dangrie158/AtmoNode/BOM.xlsx

Id | Designator | Footprint | Quantity | Comment | Supplier and ref
1 | R12 | 603 | 1 | 560k
2 | C4,C14 | 805 | 2 | 10u
3 | L1 | 0402.77x0.64mm_HandSolder | 1 | DNP
5 | U5 | Bosch_LGA-8_2.5x2.5mm_P0.65mm_ClockwisePinNumbering | 1 | BME280
6 | R11,R10,R9,R13,R8,R7,R5 | 402 | 7 | 4.7k
7 | C24,C15,C16,C12,C10,C9,C5,C3,C2,C1 | 402 | 10 | 100n 16V
9 | C20,C21 | 603 | 2 | 1u 16V
10 | L2 | 402 | 1 | 3.9nH
19 | Q2,Q1 | SOT-23 | 2 | S9012
20 | R14,R15 | 402 | 2 | 47k
21 | J2 | WiseChip VG-6432TSWAG01 | 1 | OLED_I2C
22 | R3,R6,R4 | 402 | 3 | 12k
23 | U2 | SOIC | 1 | CH340C
25 | C19 | 603 | 1 | 4.7u/16V
26 | C17 | 603 | 1 | 2.2u/16V
28 | R2,R1 | 402 | 2 | 470
29 | C22 | 402 | 1 | 100n 16V
30 | C18 | 402 | 1 | 100n 16V
31 | C13,C11 | 402 | 2 | 10p
32 | C8,C6 | 402 | 2 | DNP
33 | C7 | 402 | 1 | 6pf
35 | Y1 | 3225 | 1 | 26MHz
36 | Q4 | SOT-23 | 1 | FDN335N
37 | Q3 | SOT-23 | 1 | FDN338P
40 | U4 | SOIC-8 | 1 | W25Q16JVSSIQ
41 | U3 | QFN-32 | 1 | ESP8266EX
42 | U1 | SOT-223 | 1 | AP1117-33
45 | D1 | D_SOD-123 | 1 | B5819W
46 | C23 | 603 | 1 | 4.7u/6.3V
