dangrie158/AtmoNode/Board/AtmoNode.kicad_pcb

## KiCad design Board/AtmoNode.kicad_pcb (2023-02-21)

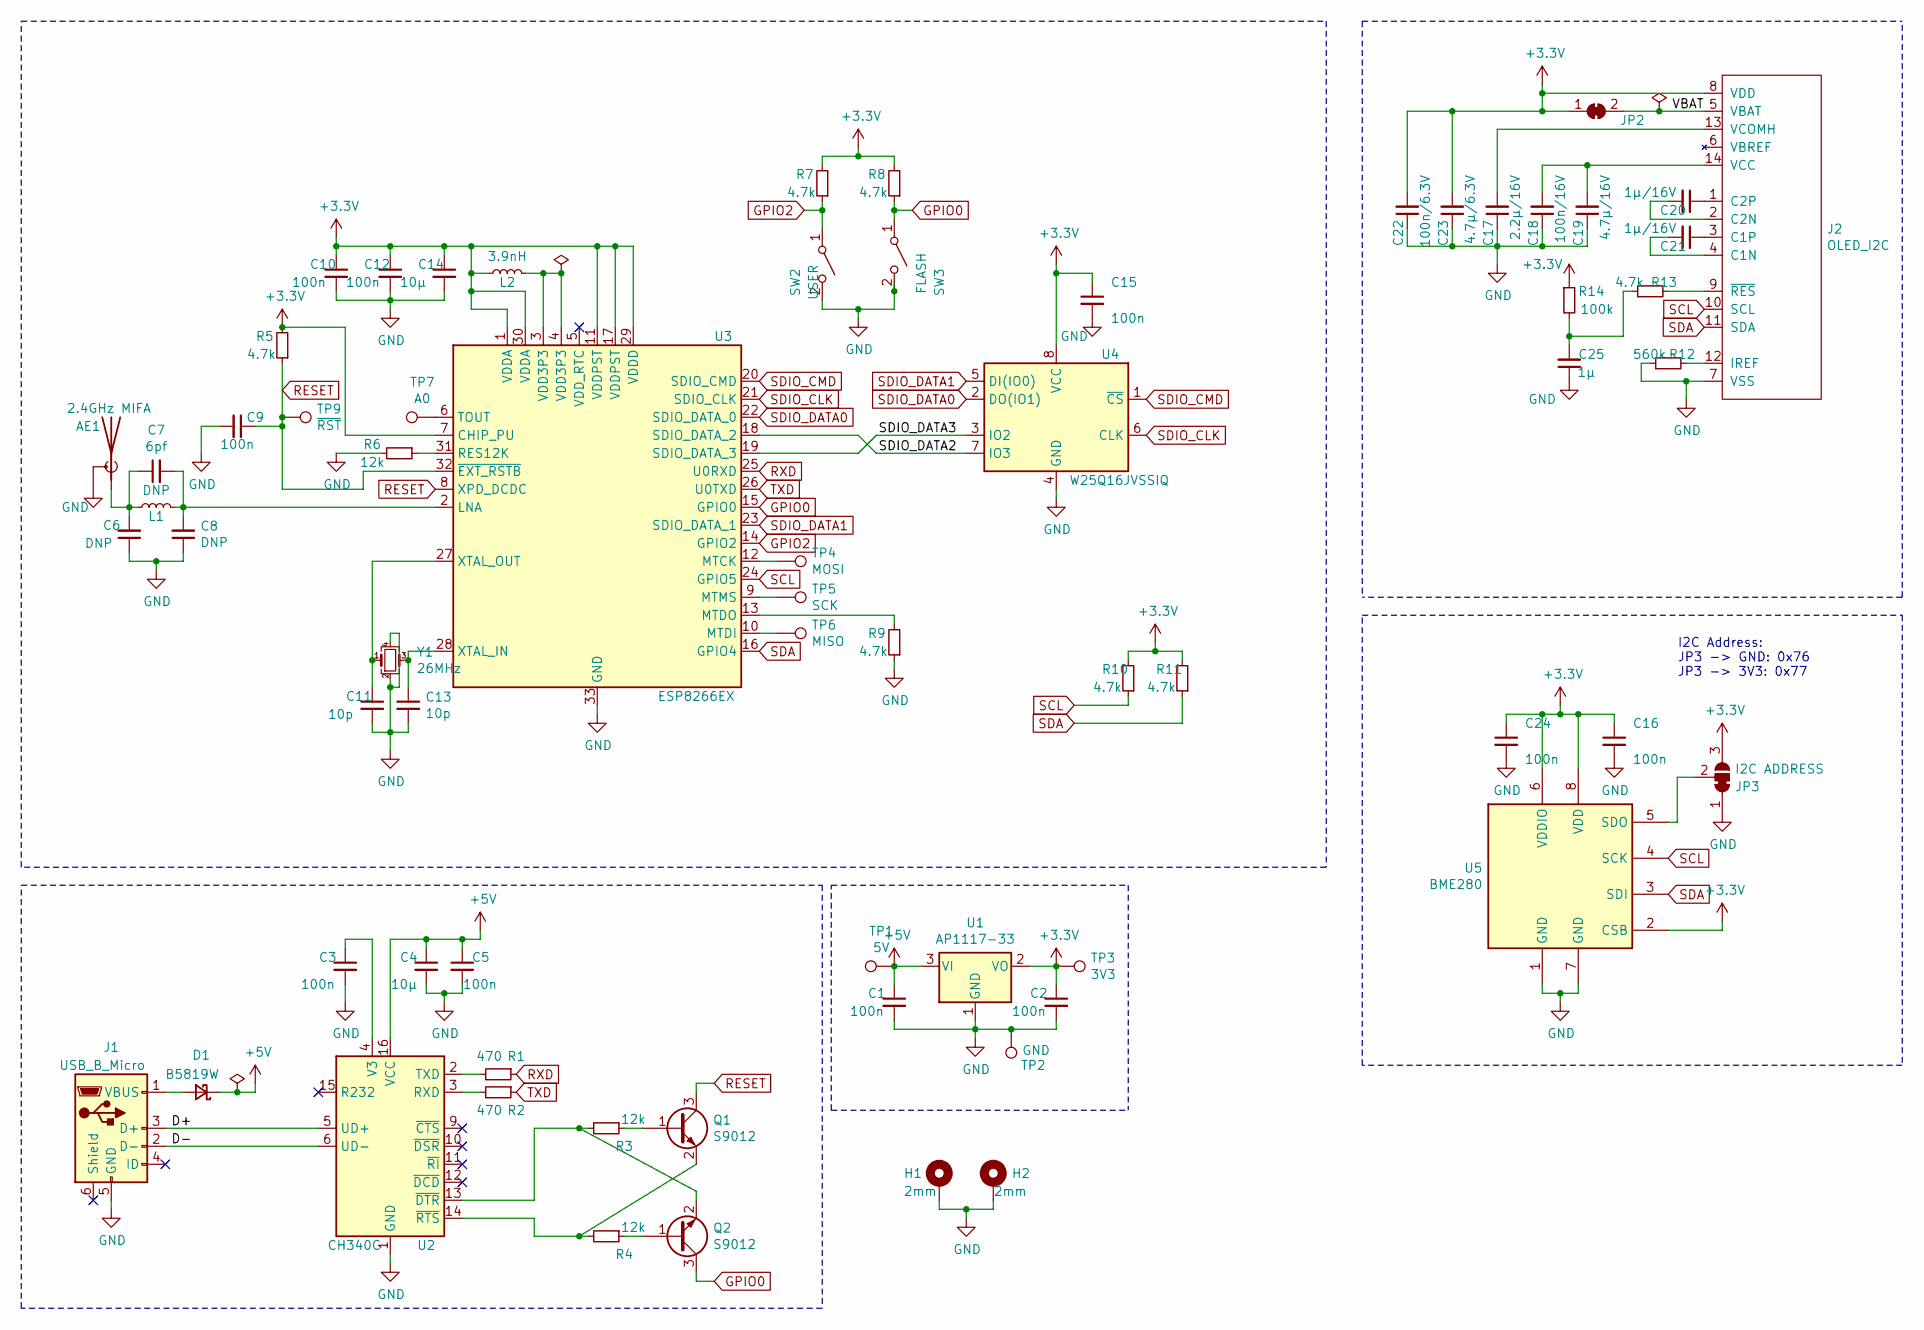
[picture p1: schematic AtmoNode.sch]

Parts:
AE1: 2.4GHz MIFA; Texas_SWRA117D_2.4GHz_Right
C1, C2, C3, C5, C9, C10, C12, C15, C16, C24: 100n; C_0402_1005Metric
C4, C14: 10µ; C_0805_2012Metric
C6, C8: DNP; C_0402_1005Metric
C7: 6pf; C_0402_1005Metric
C11, C13: 10p; C_0402_1005Metric
C17: 2.2µ/16V; C_0603_1608Metric
C18: 100n/16V; C_0402_1005Metric
C19: 4.7µ/16V; C_0603_1608Metric
C20, C21: 1µ/16V; C_0603_1608Metric
C22: 100n/6.3V; C_0402_1005Metric
C23: 4.7µ/6.3V; C_0603_1608Metric
C25: 1µ; C_0603_1608Metric
D1: B5819W; D_SOD-123
H1, H2: 2mm; MountingHole_2.2mm_M2_Pad_Via
J1: USB_B_Micro; USB_Micro-B_Amphenol_10118194_Horizontal
J2: OLED_I2C; WiseChip VG-6432TSWAG01
JP2: VDD-VBAT; SolderJumper-2_P1.3mm_Bridged_RoundedPad1.0x1.5mm
JP3: I2C ADDRESS; SolderJumper-3_P1.3mm_Bridged2Bar12_RoundedPad1.0x1.5mm
L1: DNP; L_0402_1005Metric_Pad0.77x0.64mm_HandSolder
L2: 3.9nH; L_0402_1005Metric_Pad0.77x0.64mm_HandSolder
Q1, Q2: S9012; SOT-23
R1, R2: 470; R_0402_1005Metric
R3, R4, R6: 12k; R_0402_1005Metric
R5, R7, R8, R9, R10, R11, R13: 4.7k; R_0402_1005Metric
R12: 560k; R_0603_1608Metric
R14: 100k; R_0402_1005Metric
SW2: USER; SW_SPST_CK_RS282G05A3
SW3: FLASH; SW_SPST_CK_RS282G05A3
TP1: 5V; TP1.0
TP2: GND; TP1.0
TP3: 3V3; TP1.0
TP4: MOSI; TP1.0
TP5: SCK; TP1.0
TP6: MISO; TP1.0
TP7: A0; TP1.0
TP9: ~RST; TP1.0
U1: AP1117-33; SOT-223-3_TabPin2
U2: CH340C; SOIC-16_3.9x9.9mm_P1.27mm
U3: ESP8266EX; QFN-32-1EP_5x5mm_P0.5mm_EP3.45x3.45mm
U4: W25Q16JVSSIQ; SOIC-8_5.23x5.23mm_P1.27mm
U5: BME280; Bosch_LGA-8_2.5x2.5mm_P0.65mm_ClockwisePinNumbering
Y1: 26MHz; Crystal_SMD_3225-4Pin_3.2x2.5mm

Connections:
+3V3: C2.1, C10.1, C12.1, C14.1, C15.1, C16.1, C22.2, C23.2, C24.1, J2.8 (VDD), JP2.1 (A), JP3.3 (B), L2.1, R5.2, R7.2, R8.2, R10.2, R11.2, R14.1, TP3.1, U1.2 (VO), U3.1 (VDDA), U3.7 (CHIP_PU), U3.11 (VDDPST), U3.17 (VDDPST), U3.29 (VDDD), U3.30 (VDDA), U4.8 (VCC), U5.2 (CSB), U5.6 (VDDIO), U5.8 (VDD)
+5V: C1.1, C4.1, C5.1, D1.1 (K), TP1.1, U1.3 (VI), U2.16 (VCC)
/D+: J1.3 (D+), U2.5 (UD+)
/D-: J1.2 (D-), U2.6 (UD-)
/SDIO_DATA2: U3.18 (SDIO_DATA_2), U4.7 (IO3)
/SDIO_DATA3: U3.19 (SDIO_DATA_3), U4.3 (IO2)
/VBAT: J2.5 (VBAT), JP2.2 (B)
GND: AE1.2 (Shield), C1.2, C2.2, C3.2, C4.2, C5.2, C6.1, C8.1, C9.2, C10.2, C11.2, C12.2, C13.2, C14.2, C15.2, C16.2, C17.1, C18.1, C19.1, C22.1, C23.1, C24.2, C25.1, H1.1, H2.1, J1.5 (GND), J2.7 (VSS), JP3.1 (A), R6.2, R9.1, R12.1, SW2.2 (B), SW3.2 (B), TP2.1, U1.1 (GND), U2.1 (GND), U3.33 (GND), U4.4 (GND), U5.1 (GND), U5.7 (GND), Y1.2, Y1.4
GPIO0: Q2.3 (C), R8.1, SW3.1 (A), U3.15 (GPIO0)
GPIO2: R7.1, SW2.1 (A), U3.14 (GPIO2)
unnamed: AE1.1 (A), C6.2, C7.1, L1.1
unnamed: C3.1, U2.4 (V3)
unnamed: C7.2, C8.2, L1.2, U3.2 (LNA)
unnamed: C11.1, U3.27 (XTAL_OUT), Y1.1
unnamed: C13.1, U3.28 (XTAL_IN), Y1.3
unnamed: C17.2, J2.13 (VCOMH)
unnamed: C18.2, C19.2, J2.14 (VCC)
unnamed: C20.1, J2.1 (C2P)
unnamed: C20.2, J2.2 (C2N)
unnamed: C21.1, J2.3 (C1P)
unnamed: C21.2, J2.4 (C1N)
unnamed: C25.2, R13.1, R14.2
unnamed: D1.2 (A), J1.1 (VBUS)
unnamed: J2.9 (~RES), R13.2
unnamed: J2.12 (IREF), R12.2
unnamed: JP3.2 (C), U5.5 (SDO)
unnamed: L2.2, U3.3 (VDD3P3), U3.4 (VDD3P3)
unnamed: Q1.1 (B), R3.1
unnamed: Q1.2 (E), R4.2, U2.14 (~RTS)
unnamed: Q2.1 (B), R4.1
unnamed: Q2.2 (E), R3.2, U2.13 (~DTR)
unnamed: R1.2, U2.2 (TXD)
unnamed: R2.2, U2.3 (RXD)
unnamed: R6.1, U3.31 (RES12K)
unnamed: R9.2, U3.13 (MTDO)
unnamed: TP4.1, U3.12 (MTCK)
unnamed: TP5.1, U3.9 (MTMS)
unnamed: TP6.1, U3.10 (MTDI)
unnamed: TP7.1, U3.6 (TOUT)
RESET: C9.1, Q1.3 (C), R5.1, TP9.1, U3.8 (XPD_DCDC), U3.32 (~EXT_RSTB)
RXD: R1.1, U3.25 (U0RXD)
SCL: J2.10 (SCL), R10.1, U3.24 (GPIO5), U5.4 (SCK)
SDA: J2.11 (SDA), R11.1, U3.16 (GPIO4), U5.3 (SDI)
SDIO_CLK: U3.21 (SDIO_CLK), U4.6 (CLK)
SDIO_CMD: U3.20 (SDIO_CMD), U4.1 (~CS)
SDIO_DATA0: U3.22 (SDIO_DATA_0), U4.2 (DO(IO1))
SDIO_DATA1: U3.23 (SDIO_DATA_1), U4.5 (DI(IO0))
TXD: R2.1, U3.26 (U0TXD)

Notes on the sheet:
I2C Address: JP3 -> GND: 0x76 JP3 -> 3V3: 0x77

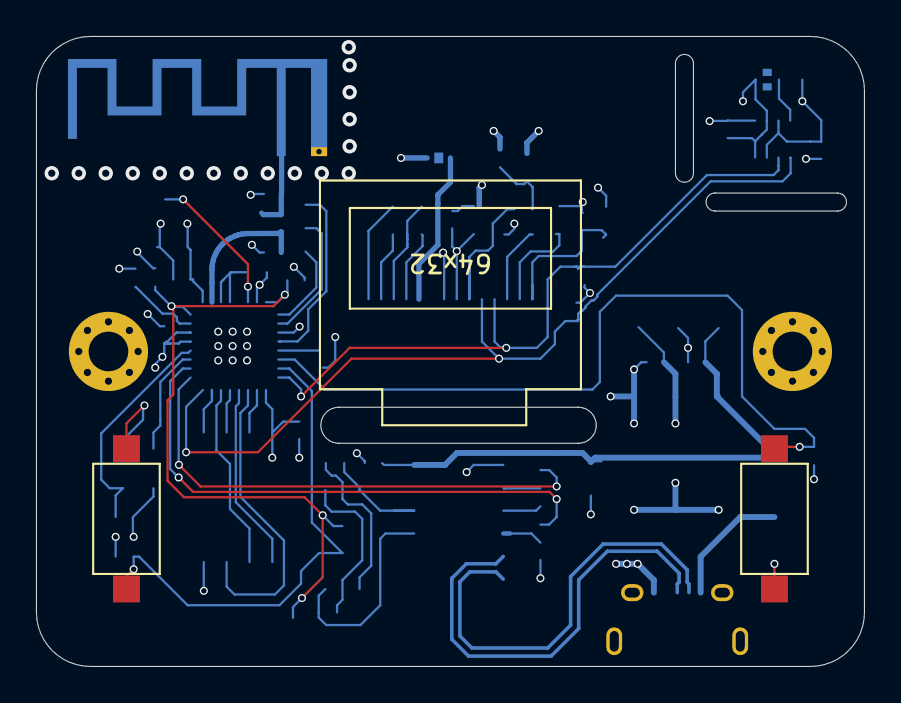
[picture p2: board AtmoNode.kicad_pcb from above]

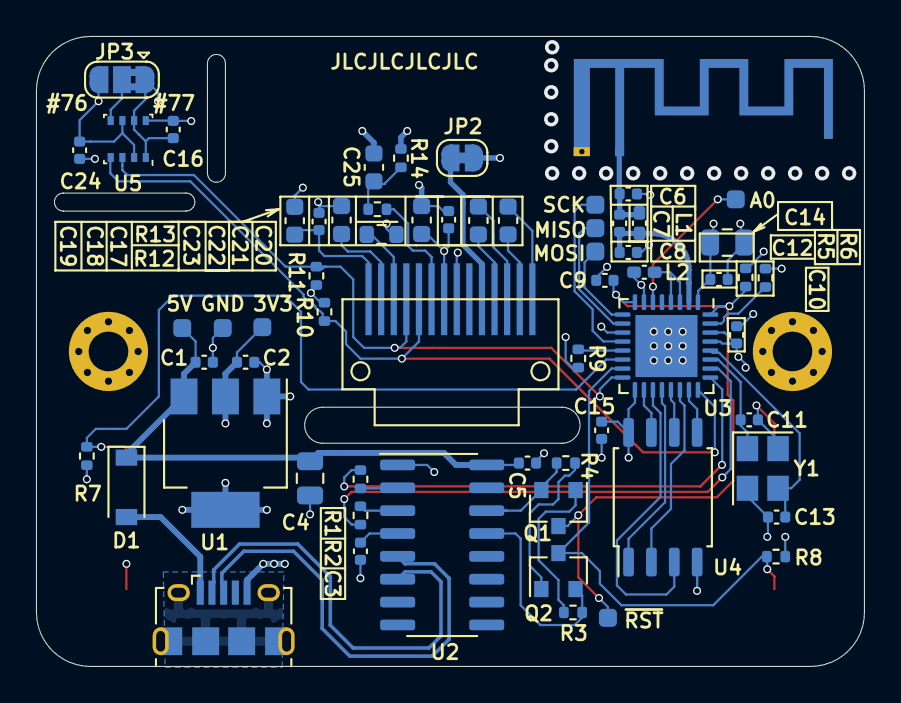
[picture p3: board AtmoNode.kicad_pcb from below]

Board: 4 copper layers, 46.0 x 35.0 mm, 67 parts (63 on the bottom side), 48 nets.
