dangrie158/AtmoNode/(commit log)

2020-12-25 added kicad project
    [AtmoNode.kicad_pcb, AtmoNode.sch, BOM.xlsx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]
2020-12-25 added ordered gerbers
    [AtmoNode-B_Cu.gbr, AtmoNode-B_Mask.gbr, AtmoNode-B_Paste.gbr, AtmoNode-B_SilkS.gbr, AtmoNode-Edge_Cuts.gbr, AtmoNode-F_Cu.gbr, AtmoNode-F_Mask.gbr, AtmoNode-F_Paste.gbr]
2020-12-25 added gitignore for kicad files
2020-12-30 added files for Laser-cut Case
    [AtmoNode.kicad_pcb]
2020-12-30 added gcode for milling the case
2023-02-21 added offset to calibrate BMS
